robertbedichek/solarthermal/schematic/solarthermal.pdf

1 | 2 | 3 | 4 | 5 | 6 | 7 | 8 | 9 | 10 | 11

AB

C

D

E

FGH

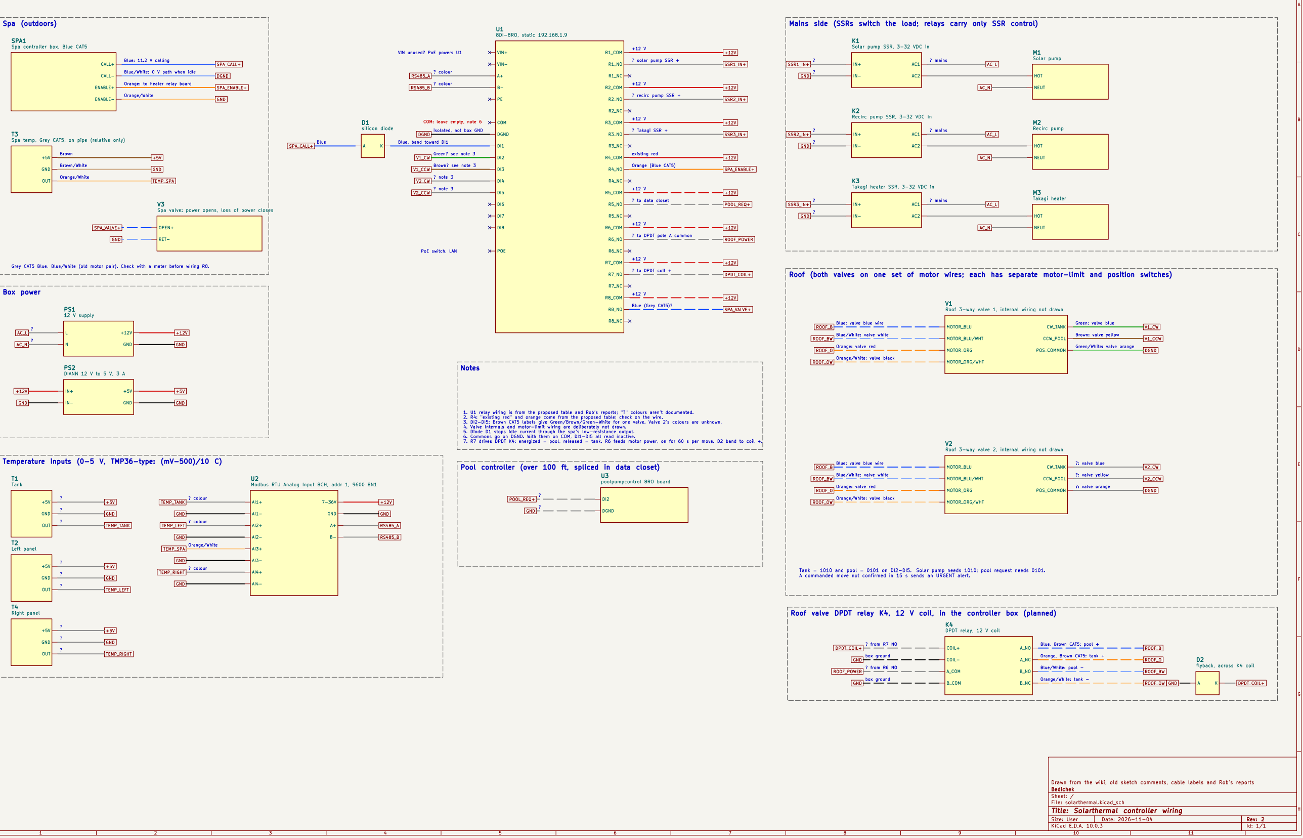
[picture p1: figure]
FGH Date: 2026-11-04; KiCad E.D.A. 10.0.3; Size: User; Rev: 2; Title: Solarthermal controller wiring; File: solarthermal.kicad_sch; Sheet: /; Bedichek; OPEN+; RET-; Tank; AC2 K1 Solar pump SSR, 3-32 VDC in; AC2 K2 Recirc pump SSR, 3-32 VDC in; Solar pump HOT NEUT M2; Recirc pump HOT NEUT M3; Takagi heater VIN+; VIN-; B- PECOM; DGND; R2_COM; R3_COM; R4_COM; R5_COM; R6_COM; R7_COM; R8_COM; U1 8DI-8RO, static 192.168.1.9; +5V GND OUT T2 Left panel +5V GND OUT T4; Right panel; MOTOR_BLU MOTOR_BLU/WHT MOTOR_ORG MOTOR_ORG/WHT; CW_TANK; CCW_POOL POS_COMMON V1; silicon diode; CCW_POOL POS_COMMON V2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

Drawn from the wiki, old sketch comments, cable labels and Rob's reports

Spa valve: power opens, loss of power closes | DI2 DGND U3

poolpumpcontrol 8RO board +5V GND OUT T1

Takagi heater SSR, 3-32 VDC in | HOT NEUT M1
DI1 DI2 DI3 DI4 DI5 DI6 DI7 DI8 POE | R1_COM

Roof 3-way valve 1, internal wiring not drawn

Roof 3-way valve 2, internal wiring not drawn

Modbus RTU Analog Input 8CH, addr 1, 9600 8N1

Spa temp, Grey CAT5, on pipe (relative only)

## Mains side (SSRs switch the load; relays carry only SSR control)

# ? recirc pump SSR + Solarthermal controller wiring (Waveshare ESP32-S3-POE-ETH-8DI-8RO)

+12 V Wire colour = conductor colour where documented. Pale tint = white-striped wire (Rob: in a pair, the wire with white is the ground). Grey = colour not documented, marked "?". Dashed = planned, not wired yet.

## Pool controller (over 100 ft, spliced in data closet)

1. U1 relay wiring is from the proposed table and Rob's reports; "?" colours aren't documented. 2. R4: "existing red" and orange come from the proposed table; check on the wire. 3. DI2-DI5: Brown CAT5 labels give Green/Brown/Green-White for one valve. Valve 2's colours are unknown. 4. Valve internals and motor-limit wiring are deliberately not drawn. 5. Diode D1 stops idle current through the spa's low-resistance output. 6. Commons go on DGND. With them on COM, DI1-DI5 all read inactive. 7. R7 drives DPDT K4: energized = pool, released = tank. R6 feeds motor power, on for 60 s per move. D2 band to coil +.
? mains ? note 3 | Blue: valve blue wire PoE switch, LAN
? | Green/White: valve orange Roof (both valves on one set of motor wires; each has separate motor-limit and position switches)

Tank = 1010 and pool = 0101 on DI2-DI5. Solar pump needs 1010; pool request needs 0101. A commanded move not confirmed in 15 s sends an URGENT alert. Orange/White

? | ? colour Temperature inputs (0-5 V, TMP36-type: (mV-500)/10 C)

Blue, Brown CAT5: pool + Roof valve DPDT relay K4, 12 V coil, in the controller box (planned)

Orange: to heater relay board Blue/White: 0 V path when idle Grey CAT5 Blue, Blue/White (old motor pair). Check with a meter before wiring R8.

? note 3 Brown? see note 3 Green? see note 3
