robertbedichek/solarthermal/RedBoard_Plus_USB-C_Schematic.pdf

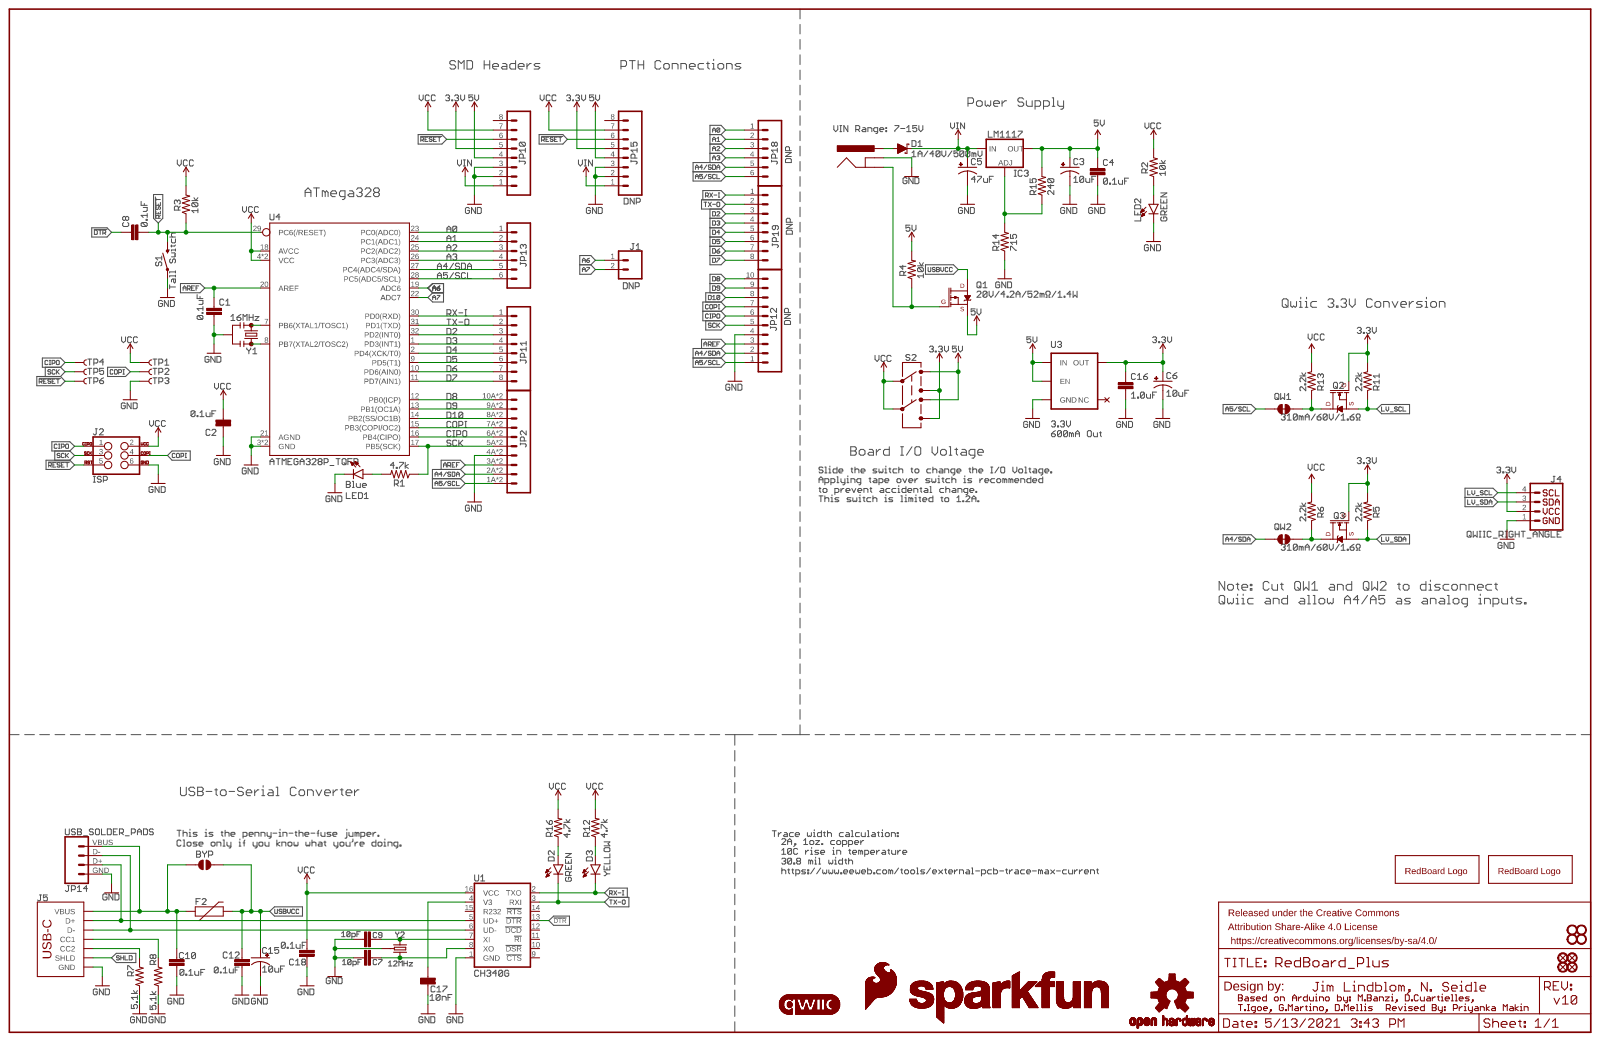
[picture p3: page 1]
