robertbedichek/solarthermal/Qwiic_Quad_Relay_Schematic-v20.pdf

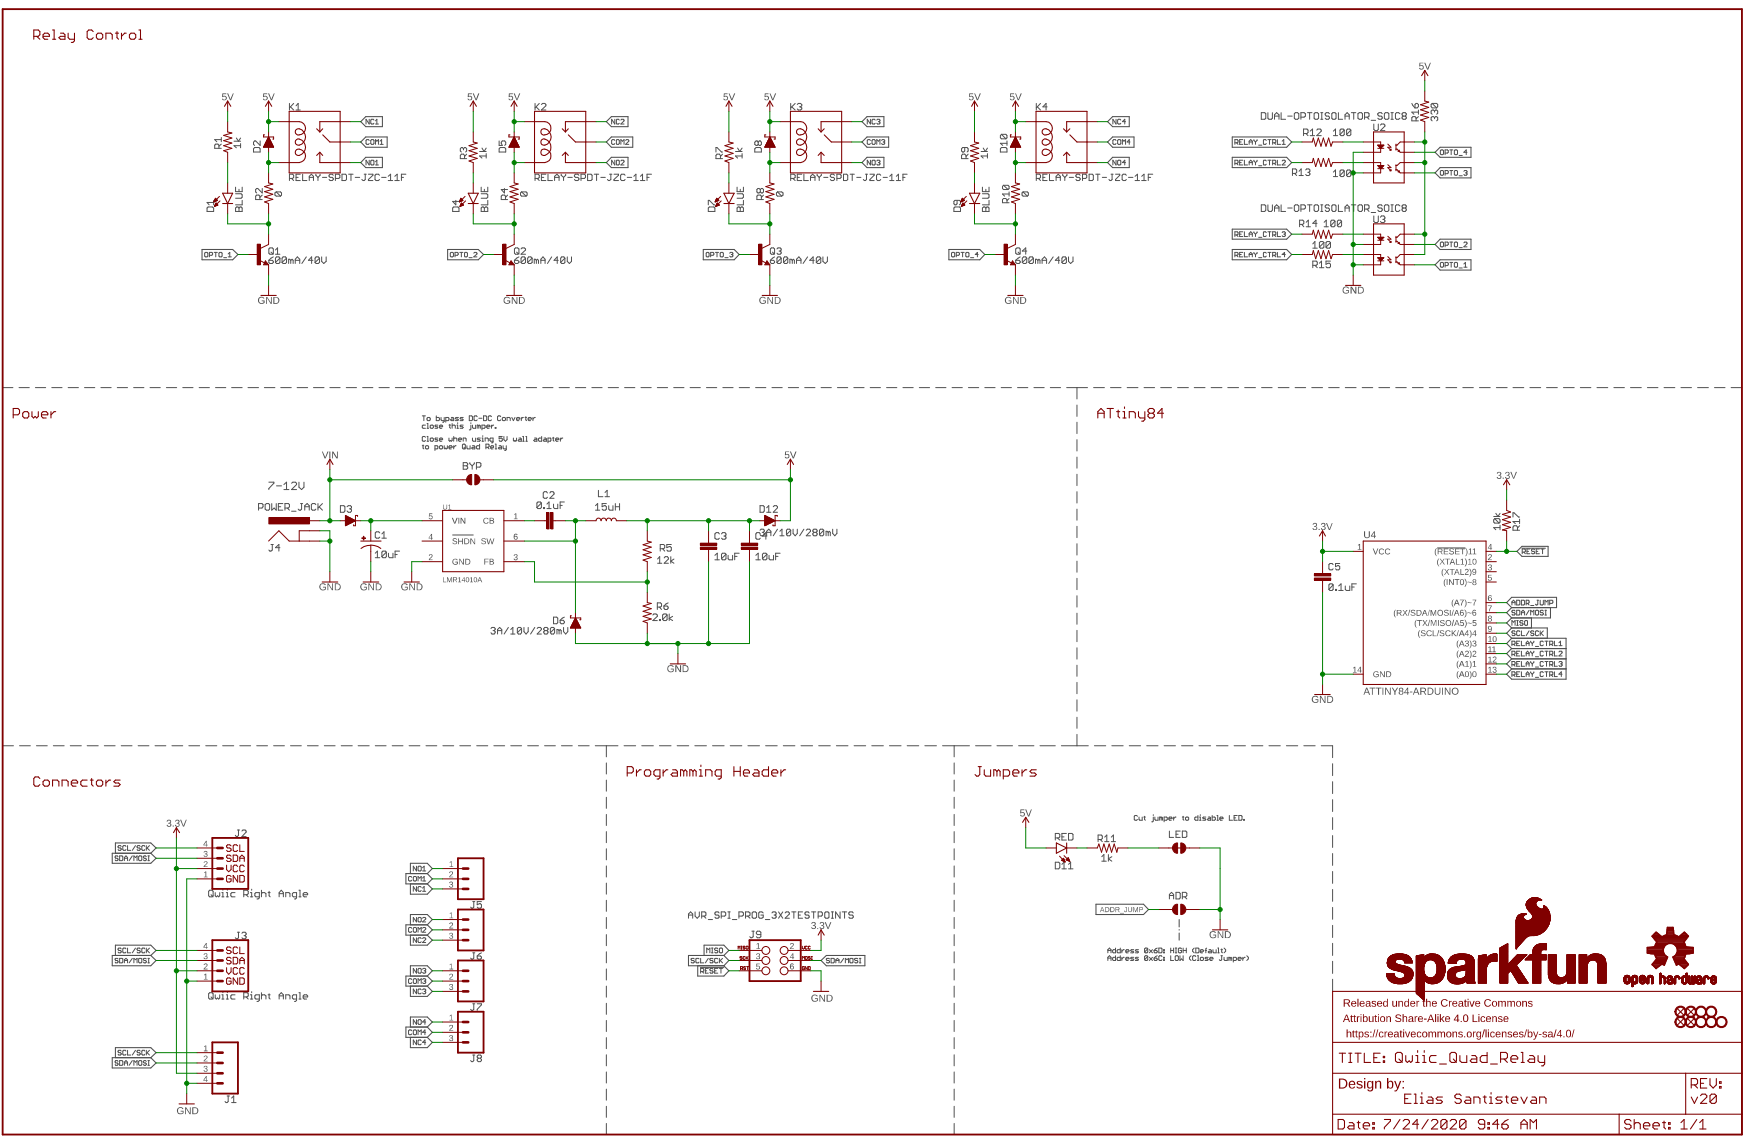
[picture p4: page 1]
