robertbedichek/solarthermal/schematic/solarthermal.kicad_sch

## KiCad design schematic/solarthermal.kicad_sch (2026-11-06)

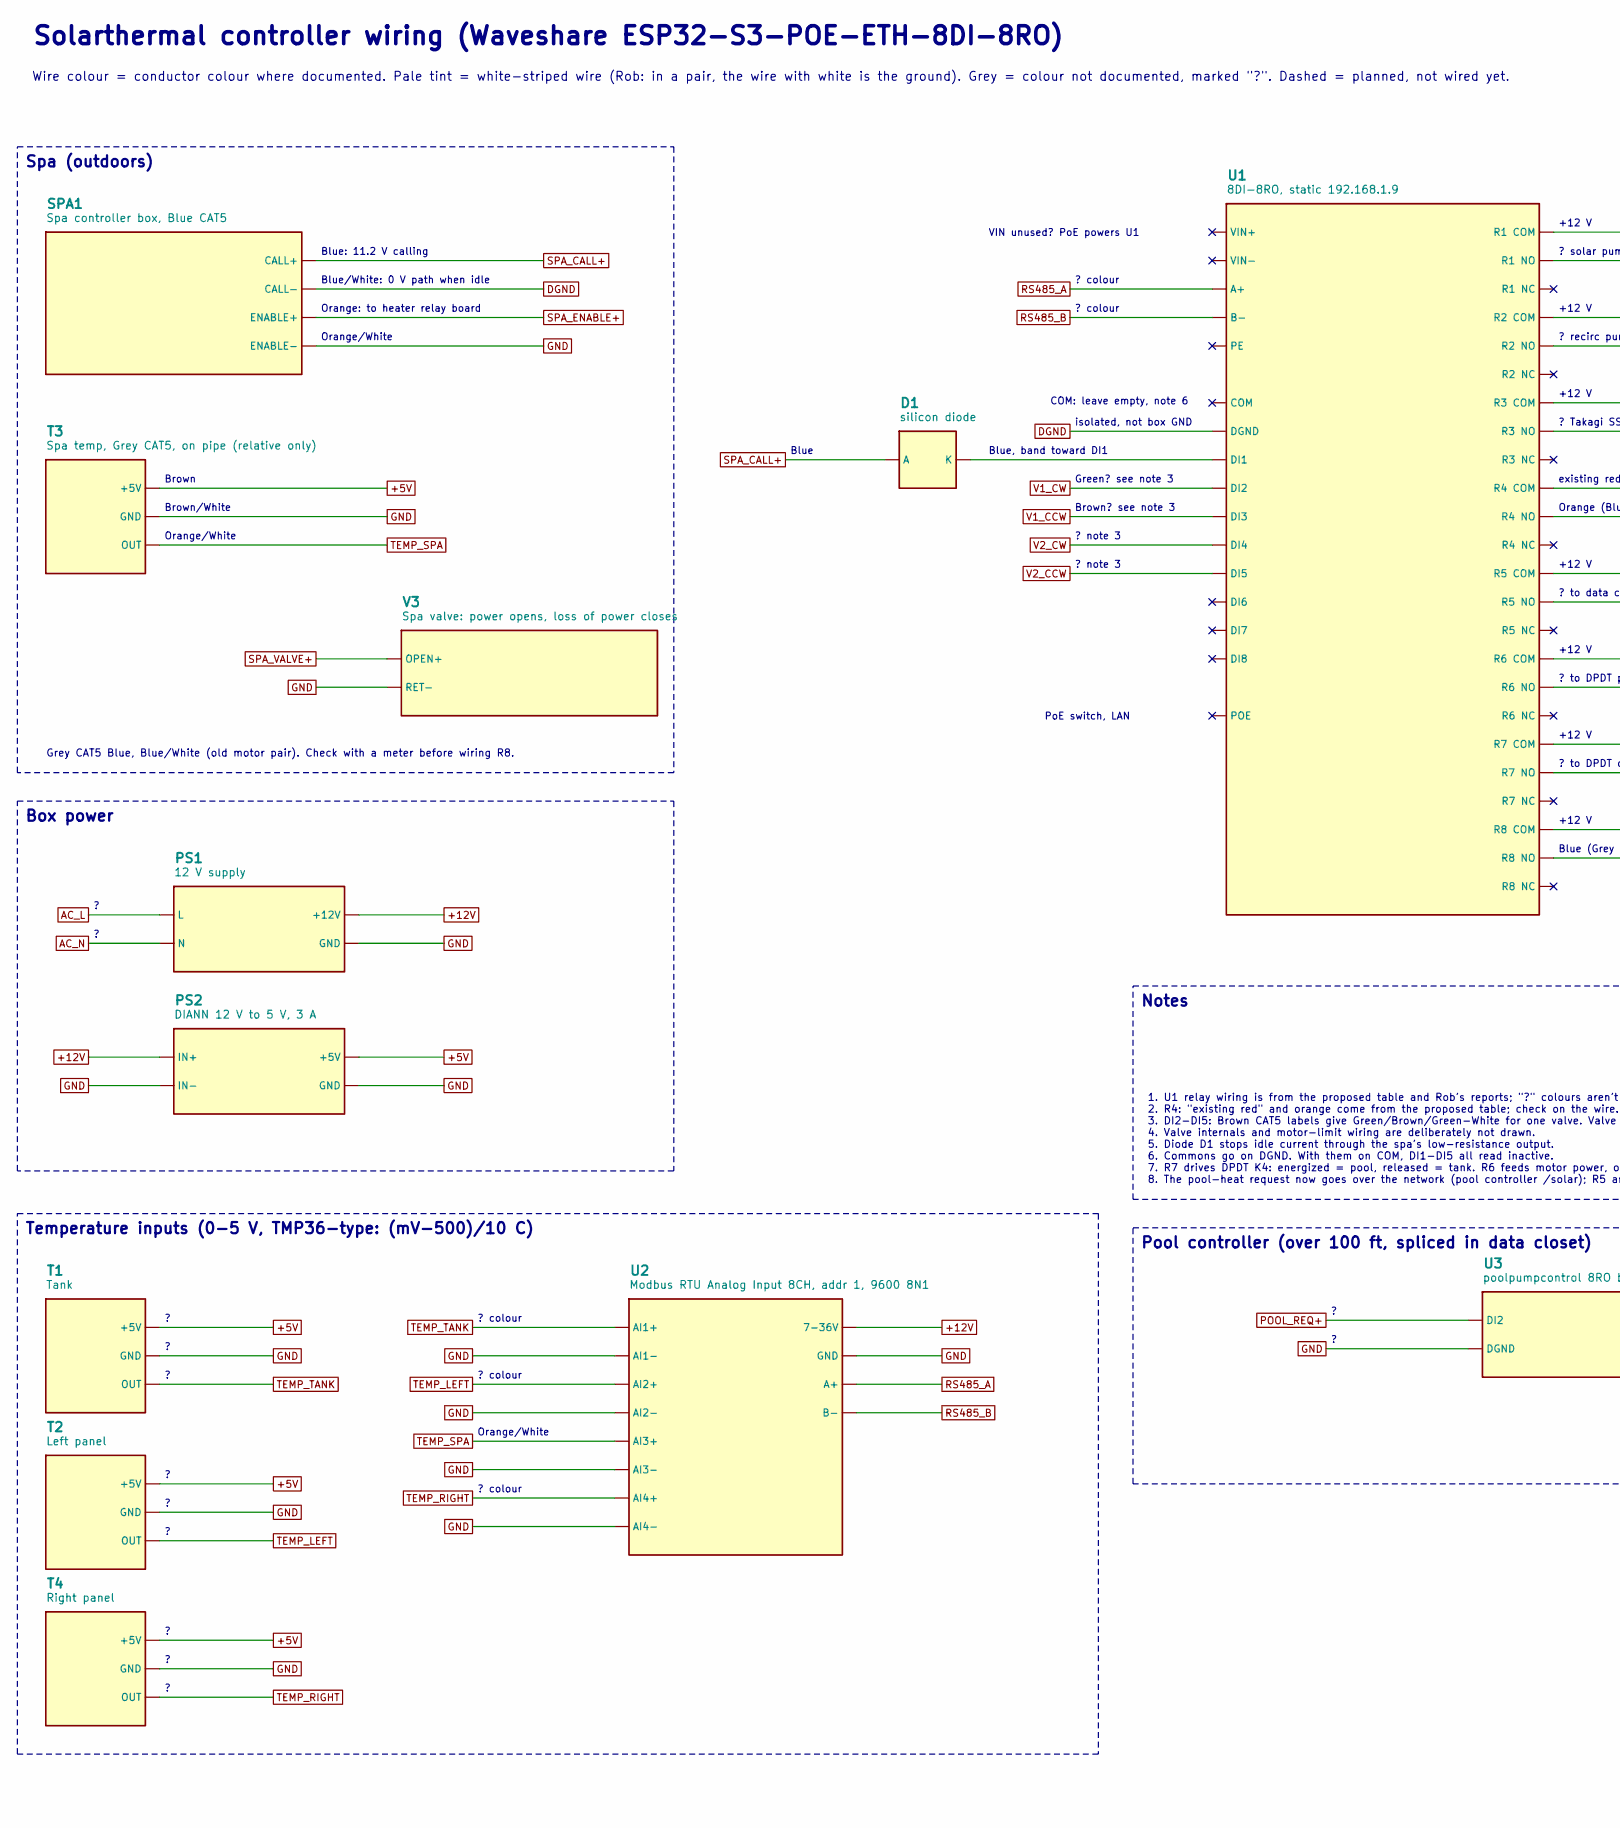
[picture p5: schematic solarthermal.kicad_sch, part in row 1, column 1]

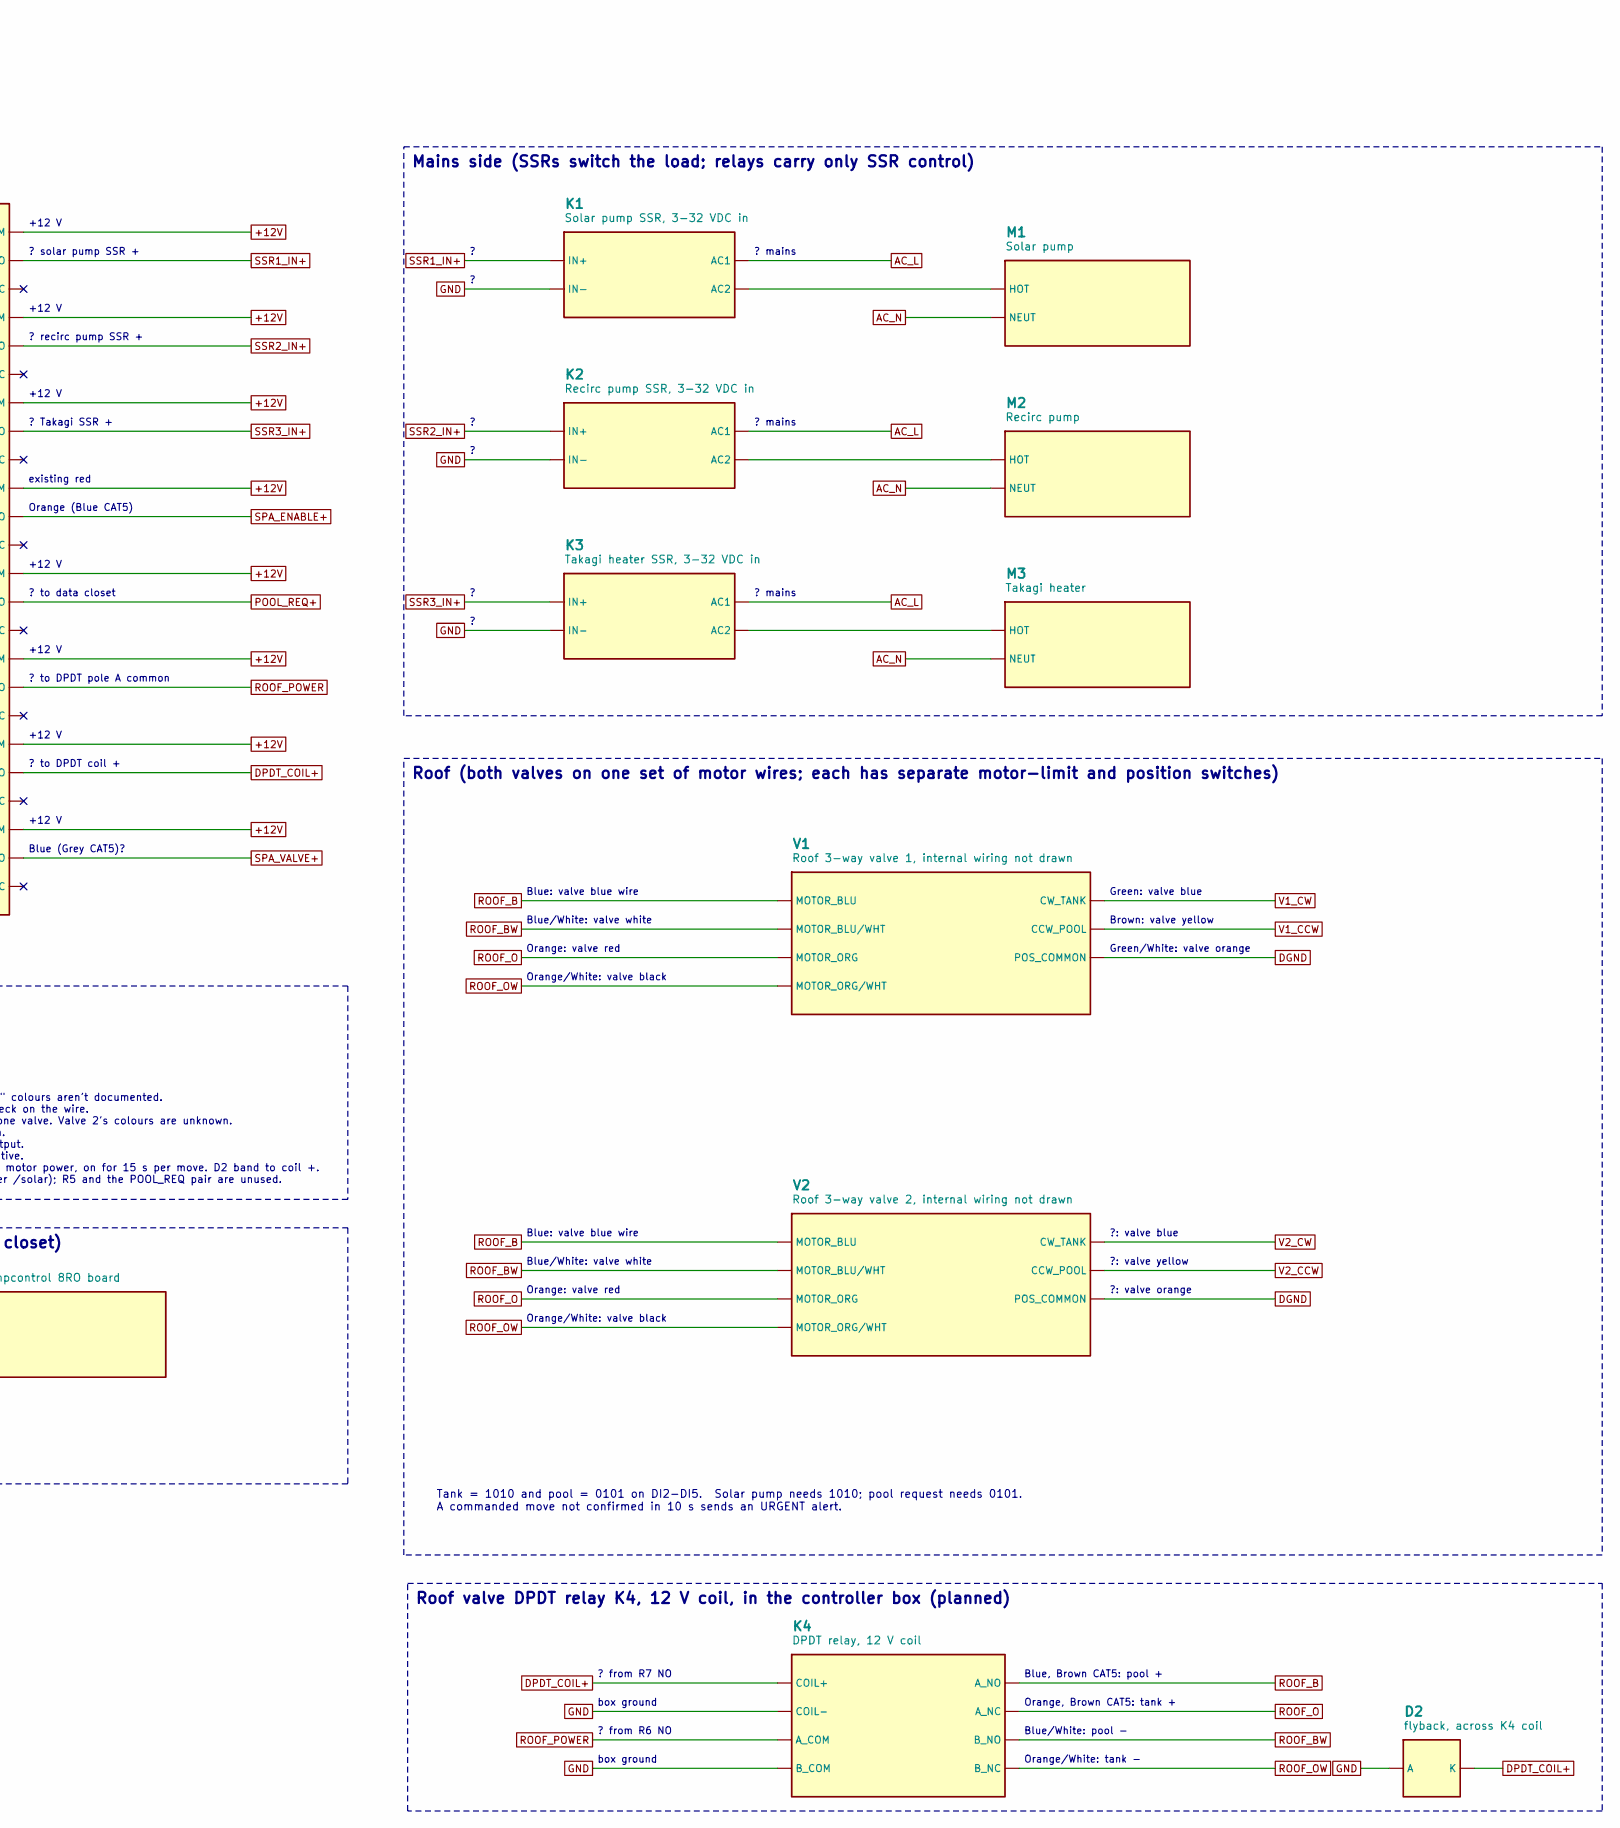
[picture p6: schematic solarthermal.kicad_sch, part in row 1, column 2]

Parts:
D1: silicon diode
D2: flyback, across K4 coil
K1: Solar pump SSR, 3-32 VDC in
K2: Recirc pump SSR, 3-32 VDC in
K3: Takagi heater SSR, 3-32 VDC in
K4: DPDT relay, 12 V coil
M1: Solar pump
M2: Recirc pump
M3: Takagi heater
PS1: 12 V supply
PS2: DIANN 12 V to 5 V, 3 A
SPA1: Spa controller box, Blue CAT5
T1: Tank
T2: Left panel
T3: Spa temp, Grey CAT5, on pipe (relative only)
T4: Right panel
U1: 8DI-8RO, static 192.168.1.9
U2: Modbus RTU Analog Input 8CH, addr 1, 9600 8N1
U3: poolpumpcontrol 8RO board
V1: Roof 3-way valve 1, internal wiring not drawn
V2: Roof 3-way valve 2, internal wiring not drawn
V3: Spa valve: power opens, loss of power closes

Connections:
+5V: PS2.3 (+5V), T1.1 (+5V), T2.1 (+5V), T3.1 (+5V), T4.1 (+5V)
+12V: PS1.3 (+12V), PS2.1 (IN+), U1.17 (R1 COM), U1.20 (R2 COM), U1.23 (R3 COM), U1.26 (R4 COM), U1.29 (R5 COM), U1.32 (R6 COM), U1.35 (R7 COM), U1.38 (R8 COM), U2.9 (7-36V)
AC_L: K1.3 (AC1), K2.3 (AC1), K3.3 (AC1), PS1.1 (L)
AC_N: M1.2 (NEUT), M2.2 (NEUT), M3.2 (NEUT), PS1.2 (N)
DGND: SPA1.2 (CALL-), U1.7 (DGND), V1.7 (POS_COMMON), V2.7 (POS_COMMON)
DPDT_COIL+: D2.2 (K), K4.1 (COIL+), U1.36 (R7 NO)
GND: D2.1 (A), K1.2 (IN-), K2.2 (IN-), K3.2 (IN-), K4.2 (COIL-), K4.4 (B_COM), PS1.4 (GND), PS2.2 (IN-), PS2.4 (GND), SPA1.4 (ENABLE-), T1.2 (GND), T2.2 (GND), T3.2 (GND), T4.2 (GND), U2.2 (AI1-), U2.4 (AI2-), U2.6 (AI3-), U2.8 (AI4-), U2.10 (GND), U3.2 (DGND), V3.2 (RET-)
unnamed: D1.2 (K), U1.8 (DI1)
unnamed: K1.4 (AC2), M1.1 (HOT)
unnamed: K2.4 (AC2), M2.1 (HOT)
unnamed: K3.4 (AC2), M3.1 (HOT)
POOL_REQ+: U1.30 (R5 NO), U3.1 (DI2)
ROOF_B: K4.5 (A_NO), V1.1 (MOTOR_BLU), V2.1 (MOTOR_BLU)
ROOF_BW: K4.7 (B_NO), V1.2 (MOTOR_BLU/WHT), V2.2 (MOTOR_BLU/WHT)
ROOF_O: K4.6 (A_NC), V1.3 (MOTOR_ORG), V2.3 (MOTOR_ORG)
ROOF_OW: K4.8 (B_NC), V1.4 (MOTOR_ORG/WHT), V2.4 (MOTOR_ORG/WHT)
ROOF_POWER: K4.3 (A_COM), U1.33 (R6 NO)
RS485_A: U1.3 (A+), U2.11 (A+)
RS485_B: U1.4 (B-), U2.12 (B-)
SPA_CALL+: D1.1 (A), SPA1.1 (CALL+)
SPA_ENABLE+: SPA1.3 (ENABLE+), U1.27 (R4 NO)
SPA_VALVE+: U1.39 (R8 NO), V3.1 (OPEN+)
SSR1_IN+: K1.1 (IN+), U1.18 (R1 NO)
SSR2_IN+: K2.1 (IN+), U1.21 (R2 NO)
SSR3_IN+: K3.1 (IN+), U1.24 (R3 NO)
TEMP_LEFT: T2.3 (OUT), U2.3 (AI2+)
TEMP_RIGHT: T4.3 (OUT), U2.7 (AI4+)
TEMP_SPA: T3.3 (OUT), U2.5 (AI3+)
TEMP_TANK: T1.3 (OUT), U2.1 (AI1+)
V1_CCW: U1.10 (DI3), V1.6 (CCW_POOL)
V1_CW: U1.9 (DI2), V1.5 (CW_TANK)
V2_CCW: U1.12 (DI5), V2.6 (CCW_POOL)
V2_CW: U1.11 (DI4), V2.5 (CW_TANK)

Notes on the sheet:
Solarthermal controller wiring (Waveshare ESP32-S3-POE-ETH-8DI-8RO)
Wire colour = conductor colour where documented. Pale tint = white-striped wire (Rob: in a pair, the wire with white is the ground). Grey = colour not documented, marked "?". Dashed = planned, not wired yet.
VIN unused? PoE powers U1
PoE switch, LAN
? colour
COM: leave empty, note 6
isolated, not box GND
Blue, band toward DI1
Blue
Green? see note 3
Brown? see note 3
? note 3
+12 V
? solar pump SSR +
? recirc pump SSR +
? Takagi SSR +
existing red
Orange (Blue CAT5)
? to data closet
? to DPDT pole A common
? to DPDT coil +
Blue (Grey CAT5)?
Spa (outdoors)
Blue: 11.2 V calling
Blue/White: 0 V path when idle
Orange: to heater relay board
Orange/White
Brown
Brown/White
Grey CAT5 Blue, Blue/White (old motor pair). Check with a meter before wiring R8.
Box power
Temperature inputs (0-5 V, TMP36-type: (mV-500)/10 C)
Mains side (SSRs switch the load; relays carry only SSR control)
? mains
Roof (both valves on one set of motor wires; each has separate motor-limit and position switches)
Blue: valve blue wire
Blue/White: valve white
Orange: valve red
Orange/White: valve black
Green: valve blue
Brown: valve yellow
Green/White: valve orange
?: valve blue
?: valve yellow
?: valve orange
Tank = 1010 and pool = 0101 on DI2-DI5. Solar pump needs 1010; pool request needs 0101. A commanded move not confirmed in 10 s sends an URGENT alert.
Roof valve DPDT relay K4, 12 V coil, in the controller box (planned)
? from R7 NO
box ground
? from R6 NO
Blue, Brown CAT5: pool +
Orange, Brown CAT5: tank +
Blue/White: pool -
Orange/White: tank -
Pool controller (over 100 ft, spliced in data closet)
Notes
1. U1 relay wiring is from the proposed table and Rob's reports; "?" colours aren't documented. 2. R4: "existing red" and orange come from the proposed table; check on the wire. 3. DI2-DI5: Brown CAT5 labels give Green/Brown/Green-White for one valve. Valve 2's colours are unknown. 4. Valve interna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
