robertbedichek/solarthermal/(commit log)

2025-02-19 SSR board did not work, so changed to using Arduino GPIOs to drive SSRs individually. Added display
    [solarthermal.ino]
2025-02-21 1. Added diagnostics modes for each output SSR and spa heat exchanger valve 2. Removed dead RTC code 3. Added logic for opening and closing spa heat exchanger valve 4. Cleaned up LCD and display code
2025-02-23 switched to ChatGPT code for sensing keys using interrupts rather than polling and used its debounce code. Scanning keys is now reliable. Had to comment-out SoftwareSerial to be able to do this. Sens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
    [solarthermal.ino]
2025-02-24 1. Added logic to monitor valve opening so that the display and serial output keep going during this process.
    2. Changed to just monitor the valve-open signal since with this particular valve, we never want to
    close it all the way (because it over-closes -- ug).
    3. Added logic to operational part to be careful to not change the valve or heater relay or solar pump
    to often (not more than once every 15 minutes). THis is just in case of a defective temperature sensor
    or circuit that might otherwise cause these mechanical things to beat themselves to death.
    This is pretty close to ready for initial testing in situ.f
2025-03-11 move one of the outputs from the relay board to a different output
2025-03-13 1. Added code for the DS3231 RTC 2. Improved variable and macro naming 3. Made updating of the LCD more efficient 4. Added booleans that correspond with temperatures that say whether the temperature 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
2025-03-15 1. Moved temperature processing code from being inline code for each sensor to using an array where each element corresponds to a sensor. a. Added option for the LM335 as I didn't want to go up to th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
    [solarthermal.ino]
2025-03-21 1. Added diag mode for Takagi 2. Reduced minimum time between valve/SSR actions to five minutes 3. Added a console input option to allow mimicing of pressing of keys through the console 4. Improved v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
    [solarthermal.ino]
2025-03-24 Mostly reorganized code for greater clarity. Tweaked some of the code around turnning solar pump on and off.
2025-03-25 1. Added statistics printed shortly after midnight with daily totals of valve cycles, minutes the solar pump was on, minutes the Takagi was on, etc. 2. Also shortly after midnight, print the build da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
    [solarthermal.ino]
2025-03-25 add Python script to consume output from Arduino
2025-03-25 Added Gnuplot script for graphing the output of the Arduino
2025-03-25 1. Added scp'ing of PNG file to bedichek.org after running gnuplot 2. Added a number of new values to plot to the Gnuplot script 3. Removed all the changes to the frequency of execution of the print_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
2025-03-26 1. Improved tuning, greatly reduced the frequency with which the spa valve is allowed to cycle 2. Improved tuning of when solar pump turns on and turns off 3. Fixed bugs that were the result of some 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
    [solarthermal.ino]
2025-03-28 1. Now run gnuplot and scp PNG when gobble script starts 2. Built in hysterisis for solar pump and electric heater thresholds 3. Fix bug in code to update LCD with Takagi status 4. Now only add in sa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
    [solarthermal.ino]
2025-03-31 1. Added "safe" mode. In this mode we just enable the spa's heater, enable the Takagi. 2. Added a second solar panel sensor. There is now a left(most) and right(most) solar panel sensor 3. Improved t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
    [solarthermal.ino]
2025-03-31 1. Added right panel to gnuplot 2. Changed temperature_F to float, which fixed the EMA problem where values drifted down to below their real values, especially as alpha got below 0.2 3. Added more di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
    [solarthermal.ino]
2025-04-01 1. Added support for a leftmost and rightmost panel temperature sensor 2. New global variable is the average of the two, if they both work, or just one of them (the working one) if not 3. Deal better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
    For scripts, no longer run gnuplot. New Python script to relaunch gobble_ on system
    reboot of it stops running for some reason.
    [solarthermal.ino]
2025-04-06 1. Gobble_thermal.py has better diagnostics when it finds garbled lines 2. solarthermal.ino: changed from global flags for which SSRs are on to directly reading the pin values. 3. Added check_memory(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
    [solarthermal.ino]
2025-04-06 Remove verbose output from turning recirc pump on and off Increased number of skipped samples to reduce volume of output
    [solarthermal.ino]
2025-04-07 Adjusted solar pump thresholds
    Fixed spa valve opening/closing and added diagnostic messages
    [solarthermal.ino]
2025-04-08 Decreased the verbosity of valve open/close operations
    Copy of HTML with the JS to plot values for solarthermal and solartracker.
2025-05-17 improved diagnostics for spa valve operations
2025-05-17 1. adjust panel temperature vs. tank temperature thresholds 2. make telemetry less frequent
2025-05-22 add datasheet for three way valves that are on roof
2025-05-28 1. Fixed many time difference calculation bugs 2. Added logic for sending a 12VDC signal to the Pool Pump Controller to request it send water to the panels. This includes a new diagnostic mode for di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
    [solarthermal.ino]
2025-05-28 Added schematic PDF for Sparkfun quad-relay Qwiic board
2025-05-28 1. Added support for second relay board to control roof valve and send request to pool pump controller
2025-05-29 fixes for new pool-heat mechanisms and change names of Python scripts to be more regular
    [watch_serial_and_run_gobble_solarthermal.py]
2025-05-30 Improve comments for roof valves; add roof valve status to LCD; disallow automatic spa hex valve changes in spa hex valve diag mode
2025-05-30 limit spew when analog values out of range; add logic to display roof valve status in serial output; fix relay code that used the wrong relay
    [solarthermal.ino]
2025-05-31 1. Collapsed the valve opening and valve closing tasks into one, valve motion, to save space and refactor. 2. Removed code for polling as it was confusing 3. Improved logic for ensuring proper drain-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
2025-06-01 1. Added logic to detect failure to send pool water to panels (by seeing that the panel temperatures remain high). In this case, we stop trying to heat the pool water and let the controller go back t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
    [gobble_solarthermal.py]
2025-06-01 Set the Arduino time when starting up and after every 1000 lines
2025-06-01 1. Lots of logic fixes to sequencing the valves, request to the pool controller. 2. Reduced code footprint by shortening rarely seen I2C errors that, if they happen, are fatal anyway
    [solarthermal.ino]
2025-06-05 set the Arduino date from the system date
2025-06-08 now set Arduino date/time if it differs from system time by more than five minutes
2025-06-10 pass rason string to relay and pump on/off functions. imporve logic for requesting pool heat, change roof vales
2025-06-10 Schematic of main controller board
2025-06-11 fix bug with the transition from heating the tank to heating the pool where it would switch the roof valves back and forth
    [solarthermal.ino]
2025-06-11 protect refrerences to quad_lv_relay[12] so that we can run this code on a bench without attached relay boards and get some meaningful output
2025-06-12 fix backup flags for valve motion and improve function names now that there are two valves. This version has a recently-introduced bug that causes the spa valve to not work properly
    [solarthermal.ino]
2025-06-12 add recognition of SSR, in case that ever starts working again
2025-06-12 fix recently introduced bug in the function that monitors spa vallve motion
    [solarthermal.ino]
2025-06-12 seed the EMA for the spa temperature sensor (in addition to doing it for the tank)
2025-07-23 Instead of taking the arithmetic mean of the two solar panel temperature sensors, take the max() of the two. Fix bug with recirc pump control where the pump would stay on if the Takagi turned on whil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
    [solarthermal.ino]
2025-08-27 1. Changed logic for opening the spa heat exchanger valve to match a new valve type. In particular, the new valve is open when powered, auto-closes when unpowered and has no status signals. 2. Fixed 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
    [solarthermal.ino]
2025-08-27 1. Moved the pool controller section to follow the solar-thermal section, putting the solar tracker at the end 2. Adjusted indices for solar thermal fields to match new output format after removing t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
2025-08-28 1. Fix potential long unsigned wrapping bug 2. Add "alert" to some messages that should trigger an alerter
    [solarthermal.ino]
2025-08-29 1. Delay closing the spa valve by a few minutes (after the spa heat request goes away). This is to protect the system from cycling on and off when the spa controller gets into an error state where it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
    [solarthermal.ino]
2025-08-30 fix a few bugs with the new delayed-close of heat exchanger valve logic
    [solarthermal.ino]
2025-09-02 adjust path on server for new root of web pages (switched to nginx)
2025-09-02 decrease valve-open time after call-for-heat removed from five to one minute
2025-09-19 many fixes suggested by Claude
    [solarthermal.ino]
2025-10-27 change time after solar pump off, before switching roof valves, to four minutes. Important that this be less than the time in poolpumpcontrol that that controller delays turning on main pump after de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
2025-10-29 reset sensor-failed flags at midnight; remove spa temperature hack; go back to arithmetic mean of two temperature sensors if they are both working; age the out-of-range counter so that some out-of-ra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
    [solarthermal.ino]
2025-10-30 1. Better handling of failed panel temperature sensors 2. Added new reasons to turn off the solar pump: a. Because the tank is not warming by a full degree per 30 minutes b. Because the tank is cooli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
    3. Due to erroneous readings from the rightmost panel's temperature sensor, this checking disables that sensor
    [solarthermal.ino]
2025-10-30 remove string parameter from one of the relay-control functions
2025-10-30 fixed assignment of analog channel to panel temperature sensor; fixed some syntax errors that somehow got checked in earlier this morning
    [solarthermal.ino]
2025-10-30 fixed left panel temperature sensor, so re-enabled it in code; now initialize the EMA filter so that we don't get a false dip on reboot; Simplified some if statements
    [solarthermal.ino]
2025-11-01 put tuning parameters at the top of the file; simplify thresholds for turning on electric spa heat enable
2025-11-07 fixed assignment of pins to left/right-most panels; removed redundant filter-seed code; removed obsolete comment
    [solarthermal.ino]
2025-11-09 improve the logic for turning on the solar pump
2025-11-09 eliminated global variable arduino_time and use local variables instead, this saves program space; also now set both the RTC and arduino time when we receive 't' and 'd' commands from the host
2025-11-10 reduce time required to turn off solar pump from 45 minutes to 15 minutes
2026-04-19 1. Update device files to reflect how USB transceivers are plugged into the Mac Mini currently. 2. Update the plist file so that log files have unique names (from other telemetry processes) 3. Add a 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
2026-09-28 Remove Safe mode
    Safe mode froze the solar pump and spa heater in whatever state they
    were in, with no timeout, while other automation kept running. A
    single Select press (or 's' over serial) from Oper entered it.
    Select now cycles Oper, Pool, Roof, D-RP, D-SP, D-TK, D-HX, D-EL.
    Telemetry mode numbers after Oper shift down by one.
2026-10-14 Watch the thermal controller's own port (11440), matching gobble_solarthermal.py
    The watcher still waited for 11240, the pool pump controller's port, so it
    stopped starting the logger when that device disappeared on 2026-10-12.
2026-10-30 Add the wiring diagrams, the KiCad project and the RedBoard schematic; ignore KiCad autosaves
2026-11-03 Port the controller to the Waveshare ESP32-S3-POE-ETH-8DI-8RO (bench only so far)
    The Arduino control logic with new I/O: eight relays on a TCA9554, Modbus analog module, static
    192.168.1.9, NTP and RTC clock, updates over Ethernet, telemetry to bedichek.org (uploads off).
    stctl builds, loads and talks to it. Analog readings carry a correction measured against a DM3058.
    Two old bugs fixed: an invalid tank temperature now turns the spa electric heat on, and the
    Takagi on-delay is 300 s rather than 300 ms.
    Relay numbers are provisional until the wiring is settled; not yet in service.
2026-11-03 Tank calibration offset 9 F on the analog module (was 15 on the Arduino)
2026-11-03 Roof valves: a CW and a CCW input per valve; hold telemetry until the sensors are read
    DI2-DI5 now read the limit switches of each valve separately. Solar pumping needs both valves
    confirmed in tank, and the pool heat request both confirmed in pool, so a stuck valve can't be taken
    for pool mode. Mismatches are reported once per pattern; no switches closed (not wired) is a note,
    not an alert, so a restart no longer sends 20 notifications. Telemetry gets a 17th column with the
    four switches. No lines are sent until the temperatures have been read.
2026-11-04 Roof valves on two board relays with a 15 s urgent check; add KiCad wiring schematic
    Relays 6 and 7 now switch the four motor wires as the old relays 2 and 3 did, in one latch write,
    with no DPDT and no power relay. A commanded move not confirmed in 15 s sends an URGENT alert.
2026-11-05 Roof valves: DPDT relay for direction, relay 6 feeds motor power for 60 s per move
    A failed limit switch can't leave a motor running. Power is off while the DPDT changes over.
    The 15 s URGENT check stays. Schematic updated.
2026-11-06 Pool-heat request over the network; roof valve timing from measurements
    - The pool-heat request goes to the pool controller (POST http://192.168.1.5/solar) every 30 s and on
    change, from its own task, with a token shared by the two controllers. The pool holds an "on" for
    90 s and answers with its state; we log it, alert if it stops answering, and drop the request
    (pool heating off for the day) if after 3 minutes it isn't sending water to the roof.
    - Relay 5 (the old 12 V request pair) is spare and held off.
    - Roof valve moves measured at 7.3 s and 7.7 s: URGENT alert after 10 s, motor power off after 15 s.
    - roof_switches keeps its leading zeros; switch alerts show the four bits.
    Co-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
